xoum/Commance_TH_sensor/(notices)

Notices in the files:
TH_sensor_v1.0.ino:
modify it under the terms of the GNU General Public License
